VerkkuUkkeli/Kiihdytin/(threads)

Thread 3 (2019-11-04):

Acrylic core with a detachable section for module interchange

chiplet, 2019-11-04:
* [x] Find where to buy appropriate acrylic tubing
* [ ] How to bend the tube to a perfect circle?
* [ ] Make jig for bending the tube

chiplet, 2024-07-03:
Acrylic was difficult to bend consistently so going for bare 3D printed accelerator tube.

Closed 2024-07-03.

Thread 4 (2019-11-04):

Self-contained accelerator modules with integrated sensors, communication bus, actuators, and debug interface

VerkkuUkkeli, 2019-11-04:
TODO: elaborate

VerkkuUkkeli, 2019-12-21:
Duplicate of #6

VerkkuUkkeli, 2019-12-21:
Reconsidering this, #6 is more about the electronics design for the segment control unit. This issue is about the status of the whole segment, including electrical and mechanical design.

VerkkuUkkeli, 2020-01-26:
SCUs will be no longer used so the issue is obsolete.

Closed 2020-01-26.

Thread 5 (2019-11-04):

Design motherboard v1

chiplet, 2019-11-04:
General:
* [x] choose microcontroller [STM32F303RE](https://www.digikey.fi/products/fi/integrated-circuits-ics/embedded-microcontrollers/685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)
* [x] board schematics
* [x] board layout

Power Supply:
* It's probably best to use a separate power supply for powering the electromagnet coils and the control circuitry to avoid EMC issues
* [x] regulate required voltages from an external wall wart
  * [x] 3.3V for the microcontroller digital logic
  * [x] 3.3V microcontroller analog reference

Interfaces:
* [x] JTAG
* [x] ST-LINK/V2-1 debugger
* [x] stack connector(s) to electromagnet driver board

TODO:
* [x] Logic level conversion from mcu to RGB

Ottis1, 2019-12-21:
This is not needed anymore since motherboard functionality is assigned to one of the segments?

VerkkuUkkeli, 2020-01-26:
MCU selection:
* All analog circuitry (photo gate sensors) shall convert their measures to digital format so the microcontroller does not have to deal with analog signals.

MCU requirements
* [ ] Enough GPIO pins (at least to support for adding IO expansion for all required signals)
  * segment indicator LEDs (16)
  * motherboard RGB (1)
  * driver board RGB (1) (can be chained with motherboard RGB)
  * electromagnet control signals (16)
  * debug UART (2)
* [ ] UART
* [ ] QFP package

VerkkuUkkeli, 2020-01-26:
## GPIO expansion considerations
Segment indicator LEDs can be driven with the control signals without much issue. A good solution would be to use a LED driver IC with 16 outputs and serial control interface, or maybe even a shift register.

IO expansion ICs allow for bidirectional I/O. This is not necessary for the segment indicators, but would be useful for reading sensors.

Shift registers:
[SN74HC595](https://www.digikey.fi/product-detail/fi/texas-instruments/SN74HC595PWR/296-23258-1-ND/1830780) is currently used for prototyping. These can be chained so 16 indicator LEDs can be controlled over a serial connection with 3 lines in total.

VerkkuUkkeli, 2020-08-16:
## MCU Implementation

TODO:
[ ] Copy reference design from STM32F3 hardware development [app note](https://www.st.com/resource/en/application_note/dm00070391-getting-started-with-stm32f3-series-hardware-development-stmicroelectronics.pdf)

chiplet, 2020-10-31:
First revision design is complete!

Closed 2020-10-31.

Thread 6 (2019-11-04):

Design Segment Control Unit (SCU) v1 electronics

VerkkuUkkeli, 2019-11-04:
General:
* [x] choose microcontroller
* [ ] sensor circuit
* [ ] electromagnet driver circuit
* [ ] board schematics
* [ ] board layout

Interfaces:
* [x] design debugger interface -- using SWD from STM32F0DISCOVERY board (ST-LINK/V2)
* [x] choose communication bus

VerkkuUkkeli, 2019-11-04:
MCU functions:
* photogate sensor(s)
  - read sensor value (analogue)
  - control IR diode
* drive high(ish) voltage electromagnet
  - control relay/FET
* indicator led(s) for magnet position
* debug
  - UART

MCU requirements
* [ ] ADC
* [ ] GPIO (at least 3)
* [ ] UART
* [ ] Small footprint
* [ ] QFP package
* [ ] Low cost

VerkkuUkkeli, 2019-12-18:
[STM32F072C8T6TR](https://www.digikey.fi/product-detail/en/stmicroelectronics/STM32F072C8T6TR/497-17359-1-ND/8024128) looks like a suitable MCU.

[datasheet](https://www.st.com/content/ccc/resource/technical/document/datasheet/cd/46/43/83/22/d3/40/c8/DM00090510.pdf/files/DM00090510.pdf/jcr:content/translations/en.DM000905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)

VerkkuUkkeli, 2019-12-18:
Also remember to by a [STM32F0 discovery](https://www.digikey.fi/product-detail/en/stmicroelectronics/STM32F0DISCOVERY/497-12876-ND/3045359) board for flashing.

VerkkuUkkeli, 2019-12-18:
TODO:
* [ ] Choose regulator(s) for MCU
* [ ] Choose flashing interface connector
* [ ] Choose FETs / relays used
* [ ] Choose CAN transceiver

VerkkuUkkeli, 2019-12-21:
HSE crystal selection:

[ECS-80-18-30B-JEM-TR](https://www.digikey.fi/product-detail/fi/ecs-inc/ECS-80-18-30B-JEM-TR/XC2105CT-ND/5875589) seems suitable.

gain margin = 18.7 (> 5 so all good)

computed with values:
* ESR = 100 ohm
* C_L = 18pF
* C_0 = 5pF
* F = 8 MHz
* g_m = 10 mA/V

See [AN2867](https://www.st.com/content/ccc/resource/technical/document/application_note/c6/eb/5e/11/e3/69/43/eb/CD00221665.pdf/files/CD00221665.pdf/jcr:content/translations/en.C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) section 3.4 for formulae

VerkkuUkkeli, 2019-12-22:
There probably isn't going to be enough space for a relay... :(

Relays would be nice because they make nice clicking sounds, but they are slow and big compared to load switches. Load switches also seem to be preferable over using plain FETs as they have adequate current and voltage range (4A at 12V) with much smaller footprint and additional protection circuitry.

[BTS50451EJAXUMA1](https://www.digikey.fi/product-detail/fi/infineon-technologies/BTS50451EJAXUMA1/BTS50451EJAXUMA1CT-ND/5413734) seems promising for the electromagnet driver. The max load inductance must still be verified to see if this IC can be used for driving the electromagnet.

VerkkuUkkeli, 2020-01-26:
SCUs will be no longer used so the issue is obsolete.

Closed 2020-01-26.

Thread 7 (2019-12-21):

Configure SCU CAN peripheral

VerkkuUkkeli, 2019-12-21:
Configure STM32F072 bxCAN peripheral for use.

TODO:
* [ ] Enable peripheral clock (CANEN bit in RCC_APB1ENR register)
* [ ] Configure APB clock (PCLK)
* [ ] Bit timing -- prescaler for bxCAN
* [ ] Bit timing -- nominal bit timing and sample point ([see spec](http://esd.cs.ucr.edu/webres/can20.pdf))

VerkkuUkkeli, 2019-12-21:
The bxCAN peripheral uses APB bus clock (PCLK).

VerkkuUkkeli, 2020-01-26:
SCUs will be no longer used so the issue is obsolete.

Closed 2020-01-26.

Thread 9 (2019-12-21):

Segment CAD design

chiplet, 2019-12-21:
CAD design for accelerator segments

TODO and things to consider:
* [x] accommodate segment PCBs
* [x] accommodate photo gate sensor
* [x] accommodate electromagnet
* [ ] ~~places for electrical connectors for inter-module connections (chain units together)~~
* [ ] cable management
* [ ] EMC issues and wiring placement (try to minimise interference by smart cable routing)
* [x] how to manufacture, design with manufacturing in mind (3D printing?)

TODO: add more considerations as they come up

VerkkuUkkeli, 2020-02-20:
## Sensor placement considerations:
* [ ] Should the pipe have a hole for mounting the sensors
  * [ ] Test if the sensor works through the pipe without mounting holes

VerkkuUkkeli, 2020-03-21:
Relays / FETs are placed on top of the motherboard so there will be no need to try to accommodate them in the segments.

Ottis1, 2021-01-19:
It seems to me that only the cable management and wiring placement considerations are left in this issue. Controlling the segments happens on the motherboard so there will be no segment PCBs. Also, in my understanding the units will not be chained together in any way.
3D printing was chosen as the manufacturing method.

chiplet, 2024-07-06:
Segments have been designed and printed already

Closed 2024-07-06.

Thread 11 (2020-02-07):

Motherboard clock configuration

chiplet, 2020-02-07:
Configure the MCU to use the HSE as the clock source.

The following part of the [hardware design guide](https://www.st.com/content/ccc/resource/technical/document/application_note/31/14/f4/9d/d3/8f/48/2b/DM00070391.pdf/files/DM00070391.pdf/jcr:content/translations/en.D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) seems useful for software configuration:
"The HSERDY flag in the Clock control register (RCC_CR) indicates if the HSE oscillator is
stable or not. At startup, the clock is not released until this bit is set by hardware. An
interrupt can be generated if enabled in the Clock interrupt register (RCC_CIR).
The HSE Crystal can be switched on and off using the HSEON bit in the Clock control
register (RCC_CR)."

chiplet, 2024-07-06:
Done. The stm32f3xx-hal crate offers a convenient interface for configuring core and peripheral clocks:
https://docs.rs/stm32f3xx-hal/0.10.0/stm32f3xx_hal/rcc/index.html

Closed 2024-07-06.

Thread 13 (2020-09-03):

Design relelauta v.2.0

chiplet, 2020-09-03:
# Abbreviations
* EM - electromagnet

# TODO:
* [x] Measure EM inductance
* [x] Choose EM driver
  * Relay?
  * Load switch?
  * MOSFET?
* [ ] Indicator LEDs for EM drivers
  * [ ] Amplifiers for indicator led signal so that EM control signals are not loaded by the LEDs

## Electromagnet Specifications
* Resistance ~2 Ohm
* Inductance ~ 430 µH
=> Assuming 10A current, energy stored in inductor is E = 22mJ

## Electromagnet driver selection considerations
* High enough load current (around 10A, TBD)
* High enough power package to withstand generated heat
* Be able to withstand inductive "kicks" when switching off the electromagnet
  * Are external flywheel diodes required?
* Nice enough package for easy soldering

chiplet, 2021-01-18:
STM32 GPIO pins are a bit problematic, at least on the Blue Pill dev board. According to the reference manual, the GPIO pins should reset to floating input configuration. The configuration register contents match this configuration when inspecting memory. However, for whatever reason, when measured, the pin is pulled up to 3.3V. The boards were ordered from ebay so the issue might be that the MCU on the devboard is actually a clone which doesn't implement the floating state correctly.

Whatever the reason, this is problematic since when the pin is pulled to 3.3V an electromagnet controlled by the pin would turn on. This is not an issue after the pin has been configured as an output. However, when debugging with a breakpoint set to main, this would turn on **all** electromagnets by default at the same time and the electronics are not designed to handle that.

As a workaround I'm connecting an external 1k pull-down resistor which seems to pull the pin to around 0.7V when left "floating".

Closed 2021-05-16.

Thread 15 (2021-05-16):

Motherboard firmware

Ottis1, 2021-05-16:
Develop the firmware for the motherboard which controls the electromagnets, reads the sensors and communicates with the PC command interface via a serial connection.

TODO:

- [ ] serial communication
- [ ]

chiplet, 2024-07-06:
**TODO:**
- [ ] Serial communication
  - [ ] USART1 driver
  - [ ] Packet-based request-acknowledge command link
- [x] RGB animation (make it look like cool alien brains!)
- [ ] Sensor input interrupts
- [ ] Acceleration control sequencing

Thread 18 (2024-07-06):

Motherboard v1.3

chiplet, 2024-07-06:
Create a new motherboard hardware revision fixing the pin assignment issues in motherboard v1.2. At least RGB data signal has been moved to PA7 corresponding to SPI1_MOSI with AF5.
