VerkkuUkkeli/Kiihdytin/hw/relelauta/v2/relelauta/relelauta.kicad_pcb

## KiCad design hw/relelauta/v2/relelauta/relelauta.kicad_pcb (2021-01-31)

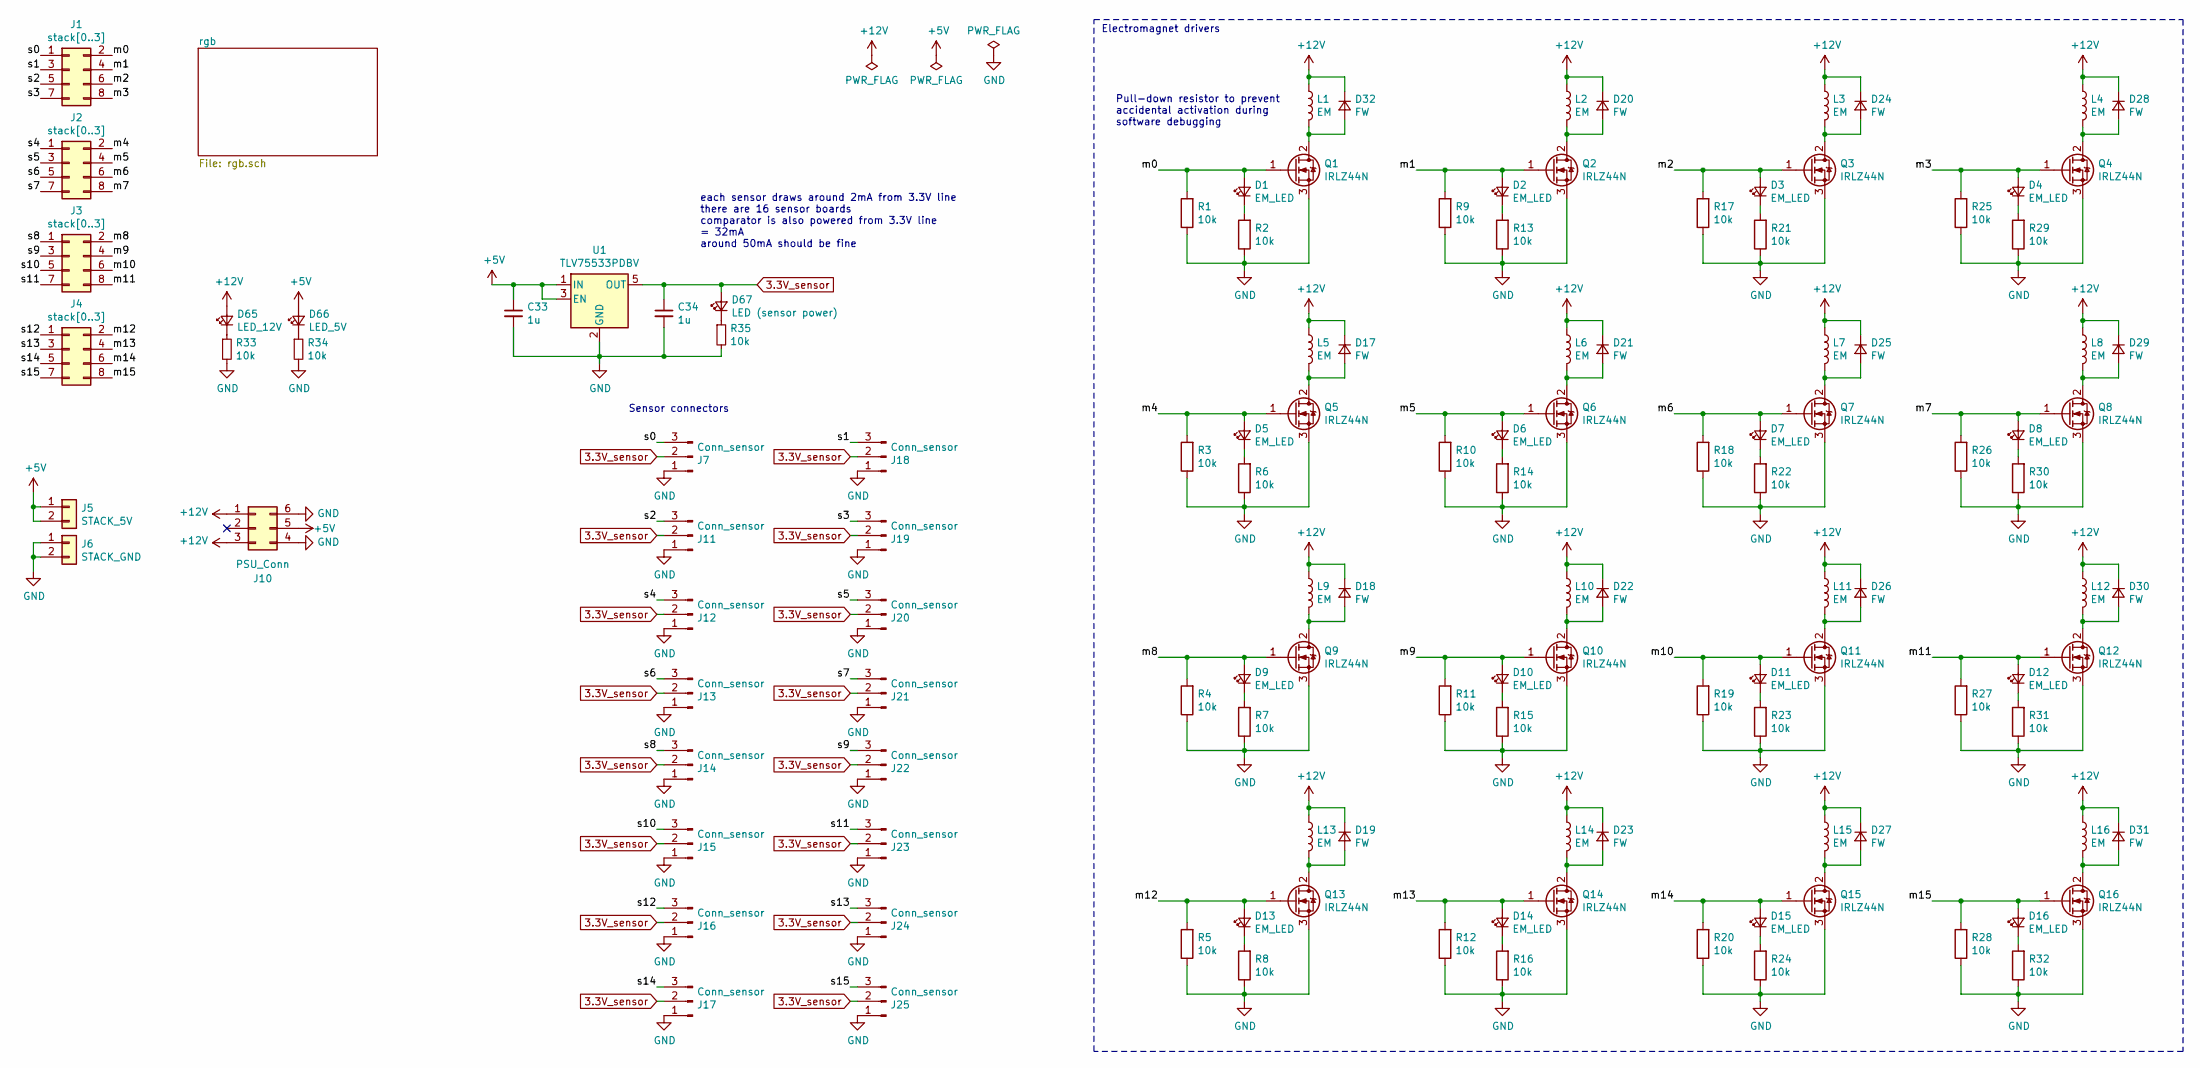
[picture p1: schematic relelauta.sch]

Parts:
C33, C34: 1u; C_0603_1608Metric
D1, D2, D3, D4, D5, D6, D7, D8, D9, D10, D11, D12, D13, D14, D15, D16: EM_LED; LED_0805_2012Metric
D17, D18, D19, D20, D21, D22, D23, D24, D25, D26, D27, D28, D29, D30, D31, D32: FW; D_DO-41_SOD81_P7.62mm_Horizontal
D65: LED_12V; LED_0805_2012Metric
D66: LED_5V; LED_0805_2012Metric
D67: LED (sensor power); LED_0805_2012Metric
J1, J2, J3, J4: stack[0..3]; PinSocket_2x04_P2.54mm_Vertical
J5: STACK_5V; PinSocket_1x02_P2.54mm_Vertical
J6: STACK_GND; PinSocket_1x02_P2.54mm_Vertical
J7, J11, J12, J13, J14, J15, J16, J17, J18, J19, J20, J21, J22, J23, J24, J25: Conn_sensor; PinHeader_1x03_P2.54mm_Horizontal
J10: PSU_Conn; Molex_Mini-Fit_Jr_5566-06A_2x03_P4.20mm_Vertical
L1, L2, L3, L4, L5, L6, L7, L8, L9, L10, L11, L12, L13, L14, L15, L16: EM; TerminalBlock_bornier-2_P5.08mm
Q1, Q2, Q3, Q4, Q5, Q6, Q7, Q8, Q9, Q10, Q11, Q12, Q13, Q14, Q15, Q16: IRLZ44N; TO-220-3_Vertical
R1, R2, R3, R4, R5, R6, R7, R8, R9, R10, R11, R12, R13, R14, R15, R16, R17, R18, R19, R20, R21, R22, R23, R24, R25, R26, R27, R28, R29, R30, R31, R32: 10k; R_0603_1608Metric
R33, R34, R35: 10k; R_0805_2012Metric
U1: TLV75533PDBV; SOT-23-5

Connections:
3.3V_sensor: C34.1, D67.2 (A), J7.2, J11.2, J12.2, J13.2, J14.2, J15.2, J16.2, J17.2, J18.2, J19.2, J20.2, J21.2, J22.2, J23.2, J24.2, J25.2, U1.5 (OUT)
+5V: C33.1, D66.2 (A), J5.1, J5.2, J10.5, U1.1 (IN), U1.3 (EN)
+12V: D17.1 (K), D18.1 (K), D19.1 (K), D20.1 (K), D21.1 (K), D22.1 (K), D23.1 (K), D24.1 (K), D25.1 (K), D26.1 (K), D27.1 (K), D28.1 (K), D29.1 (K), D30.1 (K), D31.1 (K), D32.1 (K), D65.2 (A), J10.1, J10.3, L1.1, L2.1, L3.1, L4.1, L5.1, L6.1, L7.1, L8.1, L9.1, L10.1, L11.1, L12.1, L13.1, L14.1, L15.1, L16.1
/m0: D1.2 (A), J1.2, Q1.1 (G), R1.2
/m1: D2.2 (A), J1.4, Q2.1 (G), R9.2
/m2: D3.2 (A), J1.6, Q3.1 (G), R17.2
/m3: D4.2 (A), J1.8, Q4.1 (G), R25.2
/m4: D5.2 (A), J2.2, Q5.1 (G), R3.2
/m5: D6.2 (A), J2.4, Q6.1 (G), R10.2
/m6: D7.2 (A), J2.6, Q7.1 (G), R18.2
/m7: D8.2 (A), J2.8, Q8.1 (G), R26.2
/m8: D9.2 (A), J3.2, Q9.1 (G), R4.2
/m9: D10.2 (A), J3.4, Q10.1 (G), R11.2
/m10: D11.2 (A), J3.6, Q11.1 (G), R19.2
/m11: D12.2 (A), J3.8, Q12.1 (G), R27.2
/m12: D13.2 (A), J4.2, Q13.1 (G), R5.2
/m13: D14.2 (A), J4.4, Q14.1 (G), R12.2
/m14: D15.2 (A), J4.6, Q15.1 (G), R20.2
/m15: D16.2 (A), J4.8, Q16.1 (G), R28.2
/s0: J1.1, J7.3
/s1: J1.3, J18.3
/s2: J1.5, J11.3
/s3: J1.7, J19.3
/s4: J2.1, J12.3
/s5: J2.3, J20.3
/s6: J2.5, J13.3
/s7: J2.7, J21.3
/s8: J3.1, J14.3
/s9: J3.3, J22.3
/s10: J3.5, J15.3
/s11: J3.7, J23.3
/s12: J4.1, J16.3
/s13: J4.3, J24.3
/s14: J4.5, J17.3
/s15: J4.7, J25.3
GND: C33.2, C34.2, J6.1, J6.2, J7.1, J10.4, J10.6, J11.1, J12.1, J13.1, J14.1, J15.1, J16.1, J17.1, J18.1, J19.1, J20.1, J21.1, J22.1, J23.1, J24.1, J25.1, Q1.3 (S), Q2.3 (S), Q3.3 (S), Q4.3 (S), Q5.3 (S), Q6.3 (S), Q7.3 (S), Q8.3 (S), Q9.3 (S), Q10.3 (S), Q11.3 (S), Q12.3 (S), Q13.3 (S), Q14.3 (S), Q15.3 (S), Q16.3 (S), R1.1, R2.1, R3.1, R4.1, R5.1, R6.1, R7.1, R8.1, R9.1, R10.1, R11.1, R12.1, R13.1, R14.1, R15.1, R16.1, R17.1, R18.1, R19.1, R20.1, R21.1, R22.1, R23.1, R24.1, R25.1, R26.1, R27.1, R28.1, R29.1, R30.1, R31.1, R32.1, R33.2, R34.2, R35.2, U1.2 (GND); also elsewhere on the board
unnamed: D1.1 (K), R2.2
unnamed: D2.1 (K), R13.2
unnamed: D3.1 (K), R21.2
unnamed: D4.1 (K), R29.2
unnamed: D5.1 (K), R6.2
unnamed: D6.1 (K), R14.2
unnamed: D7.1 (K), R22.2
unnamed: D8.1 (K), R30.2
unnamed: D9.1 (K), R7.2
unnamed: D10.1 (K), R15.2
unnamed: D11.1 (K), R23.2
unnamed: D12.1 (K), R31.2
unnamed: D13.1 (K), R8.2
unnamed: D14.1 (K), R16.2
unnamed: D15.1 (K), R24.2
unnamed: D16.1 (K), R32.2
unnamed: D17.2 (A), L5.2, Q5.2 (D)
unnamed: D18.2 (A), L9.2, Q9.2 (D)
unnamed: D19.2 (A), L13.2, Q13.2 (D)
unnamed: D20.2 (A), L2.2, Q2.2 (D)
unnamed: D21.2 (A), L6.2, Q6.2 (D)
unnamed: D22.2 (A), L10.2, Q10.2 (D)
unnamed: D23.2 (A), L14.2, Q14.2 (D)
unnamed: D24.2 (A), L3.2, Q3.2 (D)
unnamed: D25.2 (A), L7.2, Q7.2 (D)
unnamed: D26.2 (A), L11.2, Q11.2 (D)
unnamed: D27.2 (A), L15.2, Q15.2 (D)
unnamed: D28.2 (A), L4.2, Q4.2 (D)
unnamed: D29.2 (A), L8.2, Q8.2 (D)
unnamed: D30.2 (A), L12.2, Q12.2 (D)
unnamed: D31.2 (A), L16.2, Q16.2 (D)
unnamed: D32.2 (A), L1.2, Q1.2 (D)
unnamed: D65.1 (K), R33.1
unnamed: D66.1 (K), R34.1
unnamed: D67.1 (K), R35.1

Notes on the sheet:
Pull-down resistor to prevent accidental activation during software debugging
Sensor connectors
each sensor draws around 2mA from 3.3V line there are 16 sensor boards comparator is also powered from 3.3V line = 32mA around 50mA should be fine
Electromagnet drivers

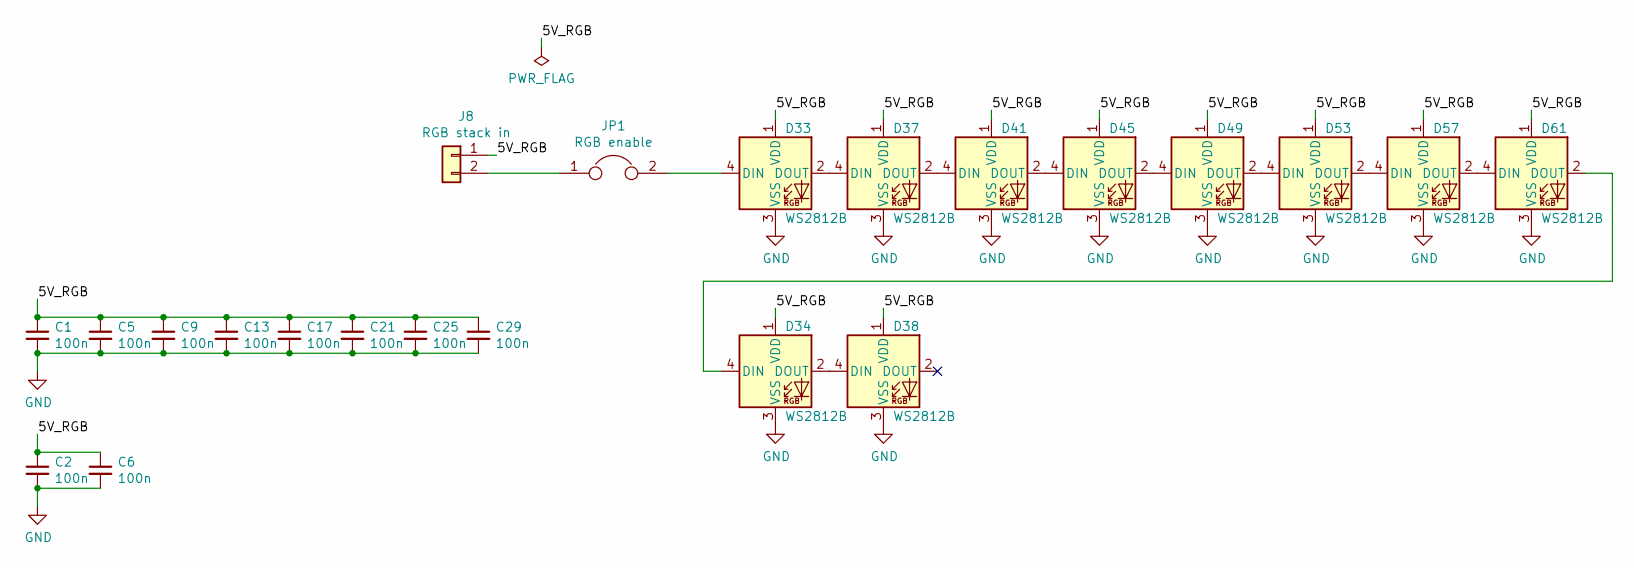
[picture p2: schematic rgb.sch]

Parts:
C1, C2, C5, C6, C9, C13, C17, C21, C25, C29: 100n; C_0603_1608Metric
D33, D34, D37, D38, D41, D45, D49, D53, D57, D61: WS2812B; LED_WS2812B_PLCC4_5.0x5.0mm_P3.2mm
J8: RGB stack in; PinSocket_1x02_P2.54mm_Vertical
JP1: RGB enable; PinHeader_2x01_P2.54mm_Vertical

Connections:
/rgb/5V_RGB: C1.1, C2.1, C5.1, C6.1, C9.1, C13.1, C17.1, C21.1, C25.1, C29.1, D33.1 (VDD), D34.1 (VDD), D37.1 (VDD), D38.1 (VDD), D41.1 (VDD), D45.1 (VDD), D49.1 (VDD), D53.1 (VDD), D57.1 (VDD), D61.1 (VDD), J8.1
GND: C1.2, C2.2, C5.2, C6.2, C9.2, C13.2, C17.2, C21.2, C25.2, C29.2, D33.3 (VSS), D34.3 (VSS), D37.3 (VSS), D38.3 (VSS), D41.3 (VSS), D45.3 (VSS), D49.3 (VSS), D53.3 (VSS), D57.3 (VSS), D61.3 (VSS); also elsewhere on the board
unnamed: D33.2 (DOUT), D37.4 (DIN)
unnamed: D33.4 (DIN), JP1.2
unnamed: D34.2 (DOUT), D38.4 (DIN)
unnamed: D34.4 (DIN), D61.2 (DOUT)
unnamed: D37.2 (DOUT), D41.4 (DIN)
unnamed: D41.2 (DOUT), D45.4 (DIN)
unnamed: D45.2 (DOUT), D49.4 (DIN)
unnamed: D49.2 (DOUT), D53.4 (DIN)
unnamed: D53.2 (DOUT), D57.4 (DIN)
unnamed: D57.2 (DOUT), D61.4 (DIN)
unnamed: J8.2, JP1.1

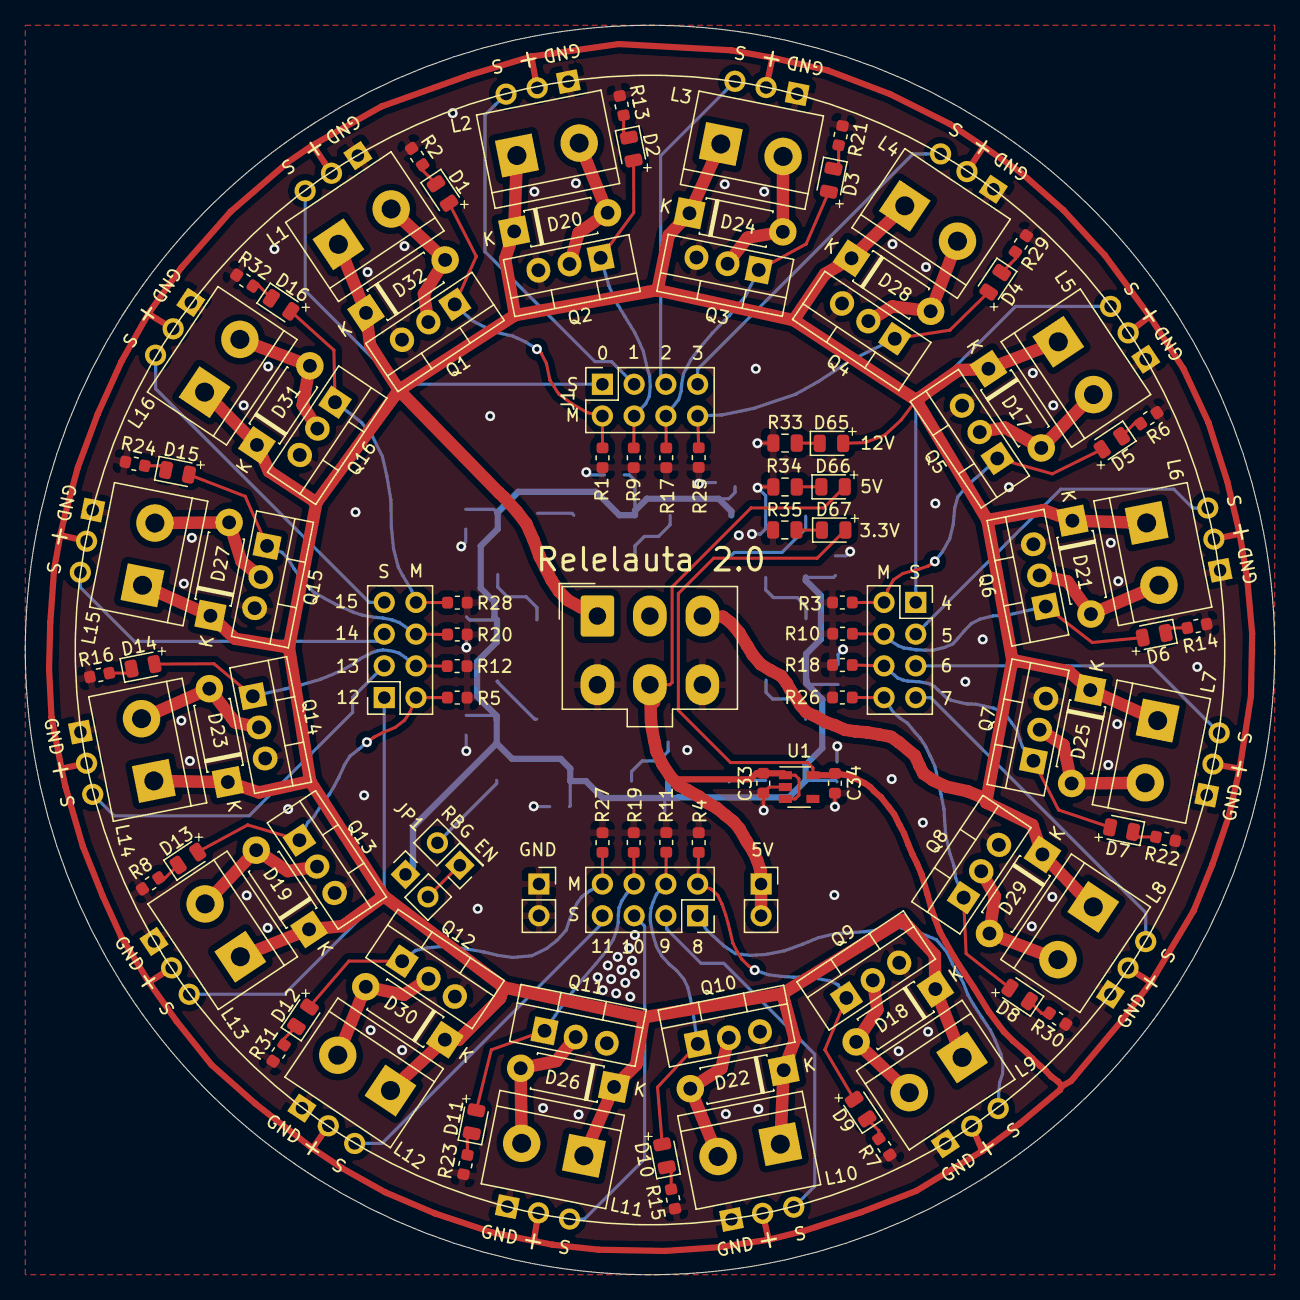
[picture p3: board relelauta.kicad_pcb from above]

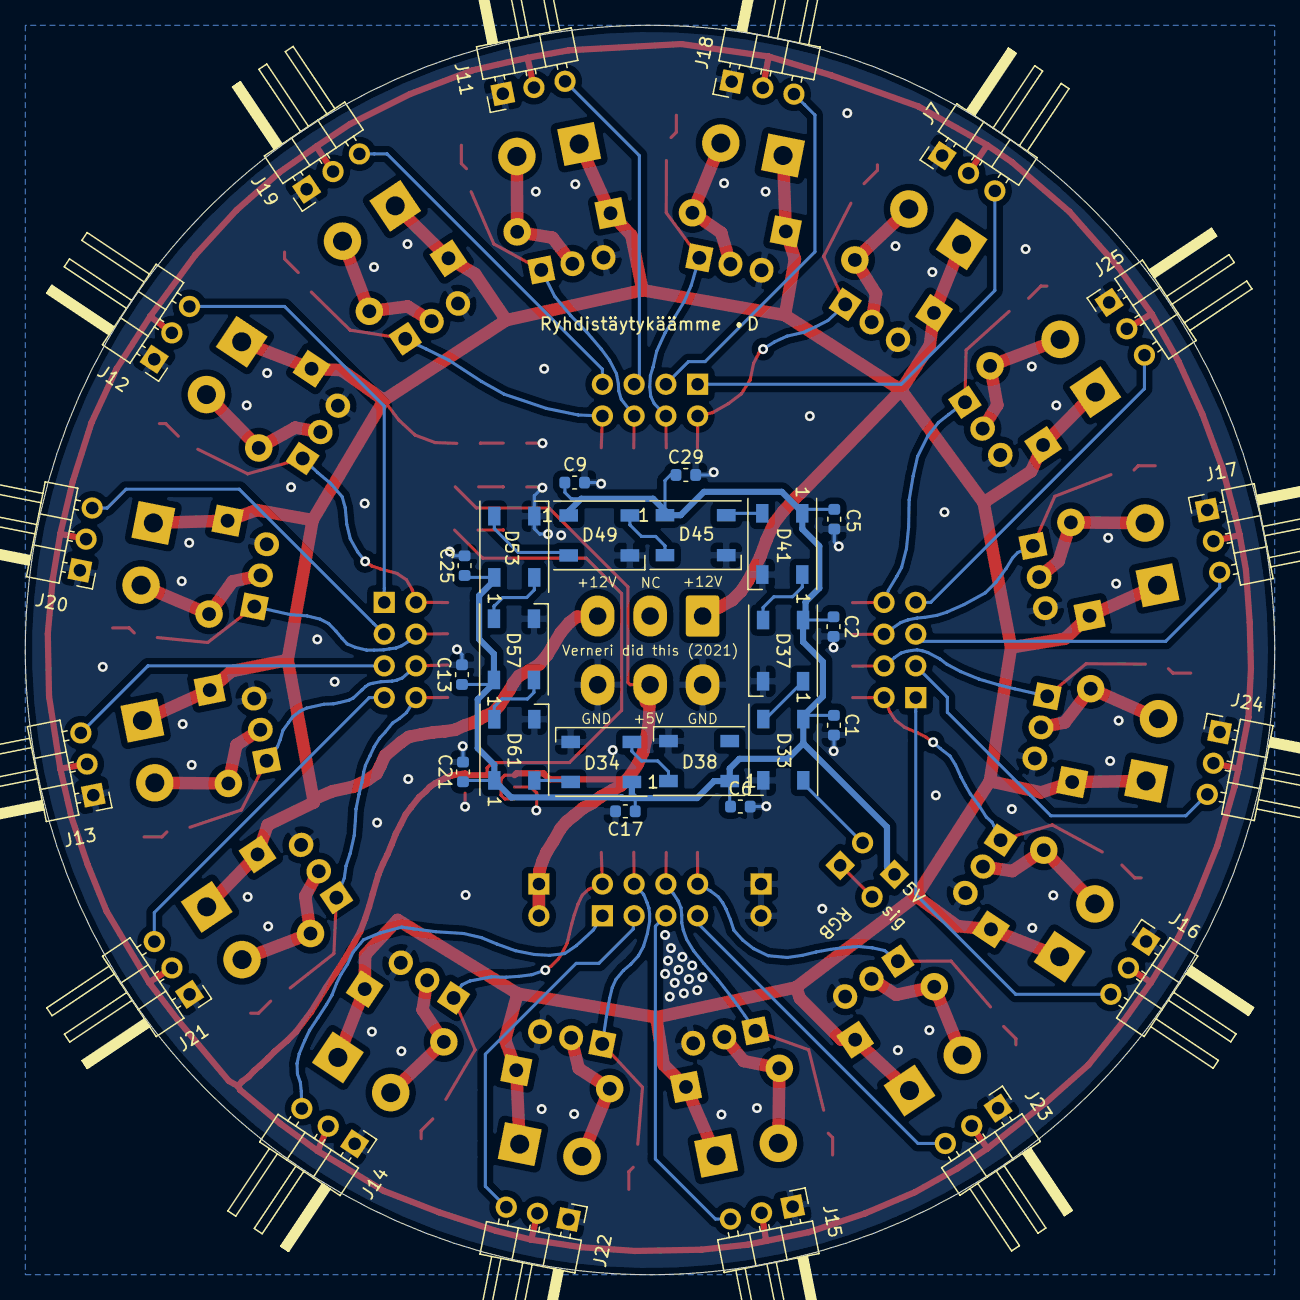
[picture p4: board relelauta.kicad_pcb from below]

Board: 2 copper layers, 100.0 x 100.0 mm, 150 parts (36 on the bottom side), 83 nets.
