VerkkuUkkeli/Kiihdytin/hw/sensorilauta/sensorilauta.kicad_pcb

## KiCad design hw/sensorilauta/sensorilauta.kicad_pcb (2021-01-31)

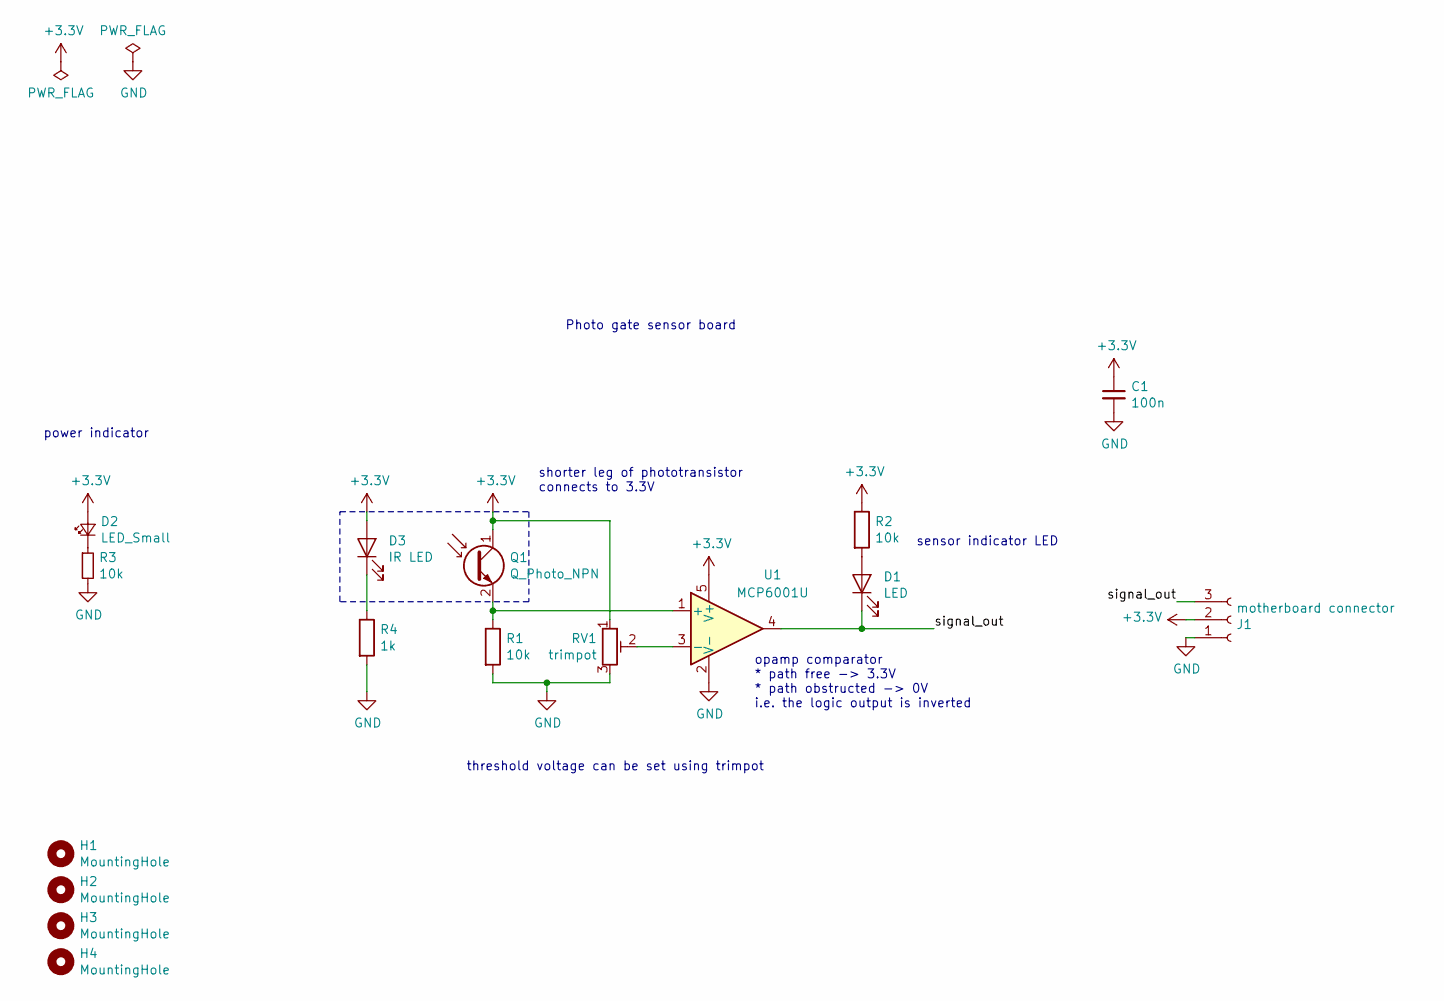
[picture p5: schematic sensorilauta.sch]

Parts:
C1: 100n; C_0805_2012Metric_Pad1.15x1.40mm_HandSolder
D1: LED; LED_D5.0mm
D2: LED_Small; LED_0805_2012Metric_Castellated
D3: IR LED; PinHeader_2x01_P2.54mm_Vertical
H1, H2, H3, H4: MountingHole; MountingHole_4.3mm_M4
J1: motherboard connector; PinHeader_1x03_P2.54mm_Horizontal
Q1: Q_Photo_NPN; PinHeader_2x01_P2.54mm_Vertical
R1, R2, R3: 10k; R_0805_2012Metric_Pad1.15x1.40mm_HandSolder
R4: 1k; R_0805_2012Metric_Pad1.15x1.40mm_HandSolder
RV1: trimpot; Potentiometer_Vishay_TS53YJ_Vertical
U1: MCP6001U; SOT-23-5_HandSoldering

Connections:
+3V3: C1.1, D2.2 (A), D3.2 (A), J1.2, Q1.1 (C), R2.1, RV1.1, U1.5 (V+)
/signal_out: D1.1 (K), J1.3, U1.4
GND: C1.2, J1.1, R1.2, R3.2, R4.2, RV1.3, U1.2 (V-)
unnamed: D1.2 (A), R2.2
unnamed: D2.1 (K), R3.1
unnamed: D3.1 (K), R4.1
unnamed: Q1.2 (E), R1.1, U1.1 (+)
unnamed: RV1.2, U1.3 (-)

Notes on the sheet:
Photo gate sensor board
opamp comparator * path free -> 3.3V * path obstructed -> 0V i.e. the logic output is inverted
threshold voltage can be set using trimpot
sensor indicator LED
power indicator
shorter leg of phototransistor connects to 3.3V

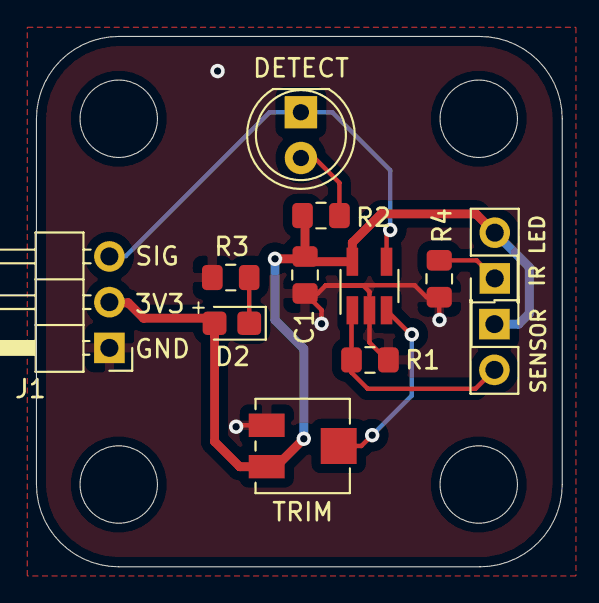
[picture p6: board sensorilauta.kicad_pcb from above]

Board: 2 copper layers, 29.2 x 29.5 mm, 16 parts (0 on the bottom side), 8 nets.
