VerkkuUkkeli/Kiihdytin/hw/motherboard/main/main.kicad_pcb

## KiCad design hw/motherboard/main/main.kicad_pcb (2021-01-31)

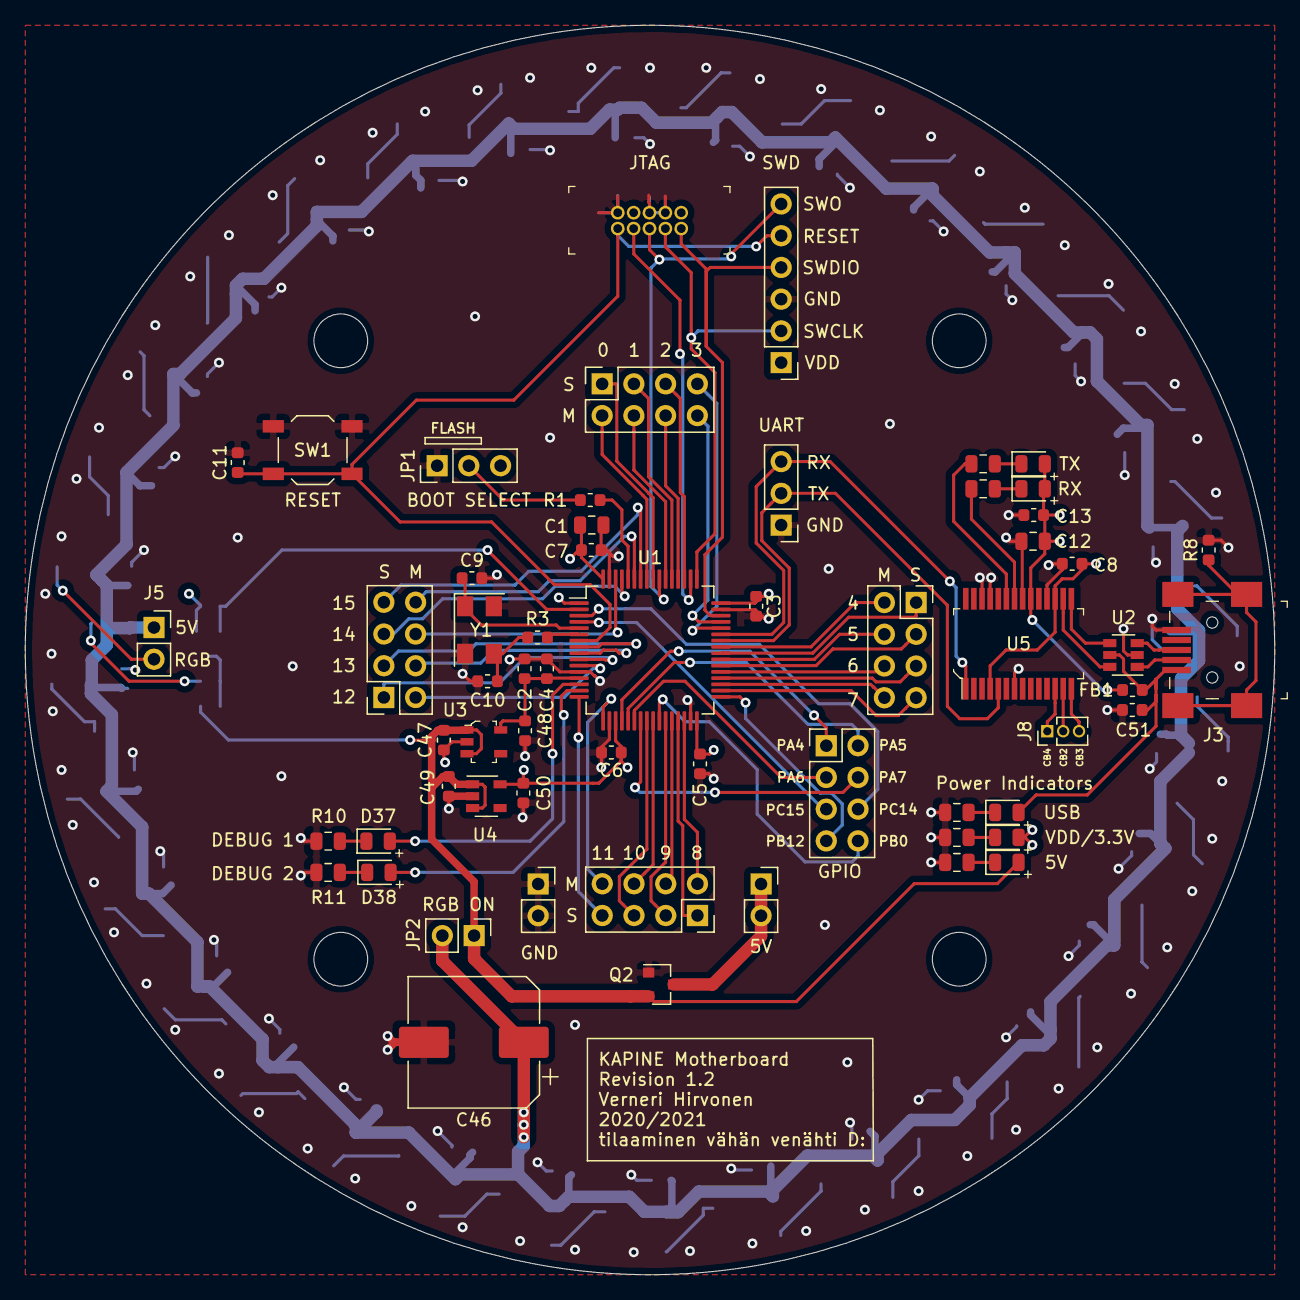
[picture p7: board hw/motherboard/main/main.kicad_pcb from above]

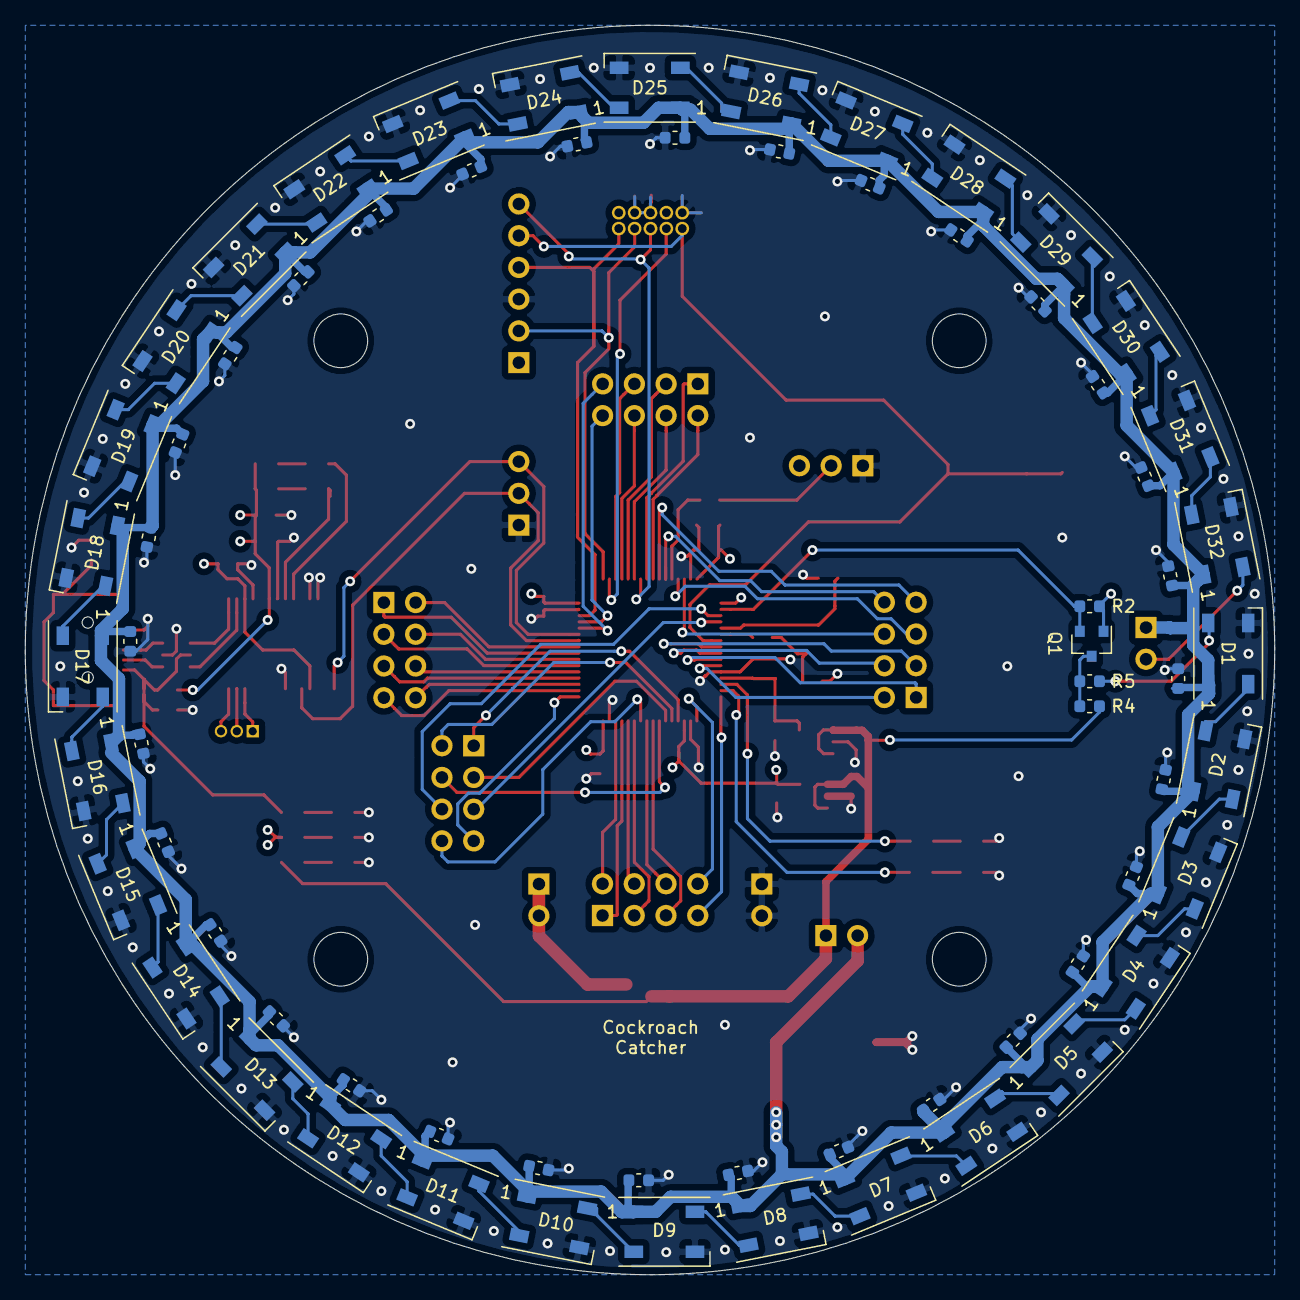
[picture p8: board hw/motherboard/main/main.kicad_pcb from below]

Board: 4 copper layers, 100.0 x 100.0 mm, 132 parts (68 on the bottom side), 115 nets.

Parts:
C1, C12: 4.7u; C_0805_2012Metric
C2, C47, C48, C49, C50: 1u; C_0603_1608Metric
C3, C5, C6, C7, C8, C11, C13, C14, C15, C16, C17, C18, C19, C20, C21, C22, C23, C24, C25, C26, C27, C28, C29, C30, C31, C32, C33, C34, C35, C36, C37, C38, C39, C40, C41, C42, C43, C44, C45: 100n; C_0603_1608Metric
C4, C51: 10n; C_0603_1608Metric
C9, C10: 27p; C_0603_1608Metric
C46: 1000u; CP_Elec_10x10
D1, D2, D3, D4, D5, D6, D7, D8, D9, D10, D11, D12, D13, D14, D15, D16, D17, D18, D19, D20, D21, D22, D23, D24, D25, D26, D27, D28, D29, D30, D31, D32: WS2812B; LED_WS2812B_PLCC4_5.0x5.0mm_P3.2mm
D33: LED_5V; LED_0805_2012Metric
D34: LED_3V3; LED_0805_2012Metric
D35: LED_TX; LED_0805_2012Metric
D36: LED_RX; LED_0805_2012Metric
D37: DEBUG_1; LED_0805_2012Metric
D38: DEBUG_2; LED_0805_2012Metric
D39: LED_USB; LED_0805_2012Metric
FB1: Ferrite_Bead; L_0603_1608Metric
H1, H2, H3, H4: MountingHole; MountingHole_4.3mm_M4
J1: SWD holes; PinHeader_1x06_P2.54mm_Vertical
J2: Conn_ARM_JTAG_SWD_10; PinHeader_2x5_P1.27mm_Drill.7mm
J3: 690-005-299-043; USB_Mini_B_Female_690-005-299-043
J4: STACK_GND; PinSocket_1x02_P2.54mm_Vertical
J5: RGB stack; PinSocket_1x02_P2.54mm_Vertical
J6: STACK_5V; PinSocket_1x02_P2.54mm_Vertical
J7: UART pins; PinHeader_1x03_P2.54mm_Vertical
J8: CBUS[2..4]; PinHeader_1x03_P1.27mm_Vertical
J9, J10, J11, J12: stack[0..3]; PinSocket_2x04_P2.54mm_Vertical
J13: GPIO; PinHeader_2x04_P2.54mm_Vertical
JP1: boot select; PinHeader_1x03_P2.54mm_Vertical
JP2: RGB ENABLE; PinHeader_1x02_P2.54mm_Vertical
Q1: BSS138; SOT-23
Q2: Q_PMOS_GSD; SOT-23
R1, R2, R4: 10k; R_0603_1608Metric
R3: 390; R_0603_1608Metric
R5: 470; R_0603_1608Metric
R6, R7, R9, R10, R11, R12, R13: 1k; R_0805_2012Metric
R8: 0; R_0603_1608Metric
SW1: SW_Push; SW_SPST_TL3342
U1: STM32F303RETx; LQFP-64_10x10mm_P0.5mm
U2: USBLC6-2SC6; SOT-23-6
U3: LP5907MFX-3_3_NOPB; SOT-753
U4: TLV75533PDBV; SOT-23-5
U5: FT232RL-REEL; SSOP-28_W5.30mm
Y1: HSE; Crystal_SMD_Abracon_ABM3C-4Pin_5.0x3.2mm

Connections:
+5V: C47.1, C49.1, D33.2, JP2.1, Q2.2, R4.1, U3.1, U3.3, U4.1, U4.3
/DEBUG_1: D37.2, U1.14
/DEBUG_2: D38.2, U1.15
/JTAG_TCK: J1.2, J2.4, U1.49
/JTAG_TDI: J2.8, U1.50
/JTAG_TDO: J1.6, J2.6, U1.55
/JTAG_TMS: J1.4, J2.2, U1.46
/PA4: J13.1, U1.20
/PA5: J13.2, U1.21
/PA6: J13.3, U1.22
/PA7: J13.4, U1.23
/PB0: J13.8, U1.26
/PB12: J13.7, U1.33
/PC14: J13.6, U1.3
/PC15: J13.5, U1.4
/RESET#: C11.1, J1.5, J2.10, SW1.2, U1.7
/USART1_RX: J7.3, U1.43, U5.1
/USART1_TX: J7.2, U1.42, U5.5
/m0: J9.2, U1.57
/m1: J9.4, U1.54
/m2: J9.6, U1.52
/m3: J9.8, U1.45
/m4: J10.2, U1.41
/m5: J10.4, U1.39
/m6: J10.6, U1.37
/m7: J10.8, U1.35
/m8: J11.2, U1.30
/m9: J11.4, U1.28
/m10: J11.6, U1.25
/m11: J11.8, U1.17
/m12: J12.2, U1.11
/m13: J12.4, U1.9
/m14: J12.6, U1.62
/m15: J12.8, U1.59
/power/5V_in: J6.1, J6.2, Q2.3
/rgb/5V_RGB: C14.1, C15.1, C16.1, C17.1, C18.1, C19.1, C20.1, C21.1, C22.1, C23.1, C24.1, C25.1, C26.1, C27.1, C28.1, C29.1, C30.1, C31.1, C32.1, C33.1, C34.1, C35.1, C36.1, C37.1, C38.1, C39.1, C40.1, C41.1, C42.1, C43.1, C44.1, C45.1, C46.1, D1.1, D2.1, D3.1, D4.1, D5.1, D6.1, D7.1, D8.1, D9.1, D10.1, D11.1, D12.1, D13.1, D14.1, D15.1, D16.1, D17.1, D18.1, D19.1, D20.1, D21.1, D22.1, D23.1, D24.1, D25.1, D26.1, D27.1, D28.1, D29.1, D30.1, D31.1, D32.1, J5.1, JP2.2
/rgb/DIN: Q1.2, R2.2, U1.2
/s0: J9.1, U1.56
/s1: J9.3, U1.53
/s2: J9.5, U1.51
/s3: J9.7, U1.44
/s4: J10.1, U1.40
/s5: J10.3, U1.38
/s6: J10.5, U1.36
/s7: J10.7, U1.34
/s8: J11.1, U1.29
/s9: J11.3, U1.27
/s10: J11.5, U1.24
/s11: J11.7, U1.16
/s12: J12.1, U1.10
/s13: J12.3, U1.8
/s14: J12.5, U1.61
/s15: J12.7, U1.58
/uart/USB_DM: U2.6, U5.16
/uart/USB_DP: U2.4, U5.15
GND: C1.2, C2.2, C3.2, C4.2, C5.2, C6.2, C7.2, C8.2, C9.2, C10.2, C11.2, C12.2, C13.2, C14.2, C15.2, C16.2, C17.2, C18.2, C19.2, C20.2, C21.2, C22.2, C23.2, C24.2, C25.2, C26.2, C27.2, C28.2, C29.2, C30.2, C31.2, C32.2, C33.2, C34.2, C35.2, C36.2, C37.2, C38.2, C39.2, C40.2, C41.2, C42.2, C43.2, C44.2, C45.2, C46.2, C47.2, C48.2, C49.2, C50.2, C51.2, D1.3, D2.3, D3.3, D4.3, D5.3, D6.3, D7.3, D8.3, D9.3, D10.3, D11.3, D12.3, D13.3, D14.3, D15.3, D16.3, D17.3, D18.3, D19.3, D20.3, D21.3, D22.3, D23.3, D24.3, D25.3, D26.3, D27.3, D28.3, D29.3, D30.3, D31.3, D32.3, J1.3, J2.3, J2.5, J2.9, J3.5, J4.1, J4.2, J7.1, JP1.1, Q2.1, R6.2, R7.2, R8.2, R10.2, R11.2, R13.2, SW1.1, U1.12, U1.18, U1.31, U1.47, U1.63, U2.2, U3.2, U4.2, U5.7, U5.18, U5.21, U5.25, U5.26, Y1.2, Y1.4
unnamed: C8.1, U5.4, U5.17
unnamed: C9.1, U1.5, Y1.1
unnamed: C10.1, R3.2, Y1.3
unnamed: D1.2, D2.4
unnamed: D1.4, R5.1
unnamed: D2.2, D3.4
unnamed: D3.2, D4.4
unnamed: D4.2, D5.4
unnamed: D5.2, D6.4
unnamed: D6.2, D7.4
unnamed: D7.2, D8.4
unnamed: D8.2, D9.4
unnamed: D10.2, D11.4
unnamed: D9.2, D10.4
unnamed: D11.2, D12.4
unnamed: D12.2, D13.4
unnamed: D13.2, D14.4
unnamed: D14.2, D15.4
unnamed: D15.2, D16.4
unnamed: D16.2, D17.4
unnamed: D17.2, D18.4
unnamed: D18.2, D19.4
unnamed: D19.2, D20.4
unnamed: D20.2, D21.4
unnamed: D21.2, D22.4
unnamed: D22.2, D23.4
unnamed: D23.2, D24.4
unnamed: D24.2, D25.4
unnamed: D25.2, D26.4
unnamed: D26.2, D27.4
unnamed: D27.2, D28.4
unnamed: D28.2, D29.4
unnamed: D29.2, D30.4
unnamed: D30.2, D31.4
unnamed: D31.2, D32.4
unnamed: D32.2, J5.2
unnamed: D33.1, R6.1
unnamed: D34.1, R7.1
unnamed: D35.1, R9.1
unnamed: D36.1, R12.1
unnamed: D37.1, R10.1
unnamed: D38.1, R11.1
unnamed: D39.1, R13.1
unnamed: J3.2, U2.1
unnamed: J3.3, U2.3
unnamed: J3.SH, R8.1
unnamed: J8.1, U5.12
unnamed: J8.2, U5.13
unnamed: J8.3, U5.14
unnamed: JP1.2, R1.2
unnamed: Q1.3, R4.2, R5.2
unnamed: R1.1, U1.60
unnamed: R3.1, U1.6
unnamed: R9.2, U5.23
unnamed: R12.2, U5.22
VBUS: C51.1, D39.2, FB1.1, J3.1, U2.5
VCC: C12.1, C13.1, D35.2, D36.2, FB1.2, U5.20
VDD: C1.1, C3.1, C5.1, C6.1, C7.1, C50.1, D34.2, J1.1, J2.1, JP1.3, Q1.1, R2.1, U1.1, U1.19, U1.32, U1.48, U1.64, U4.5
VDDA: C2.1, C4.1, C48.1, U1.13, U3.5
