VerkkuUkkeli/Kiihdytin/hw/scu/main/main.kicad_pcb

## KiCad design hw/scu/main/main.kicad_pcb (2019-12-21)

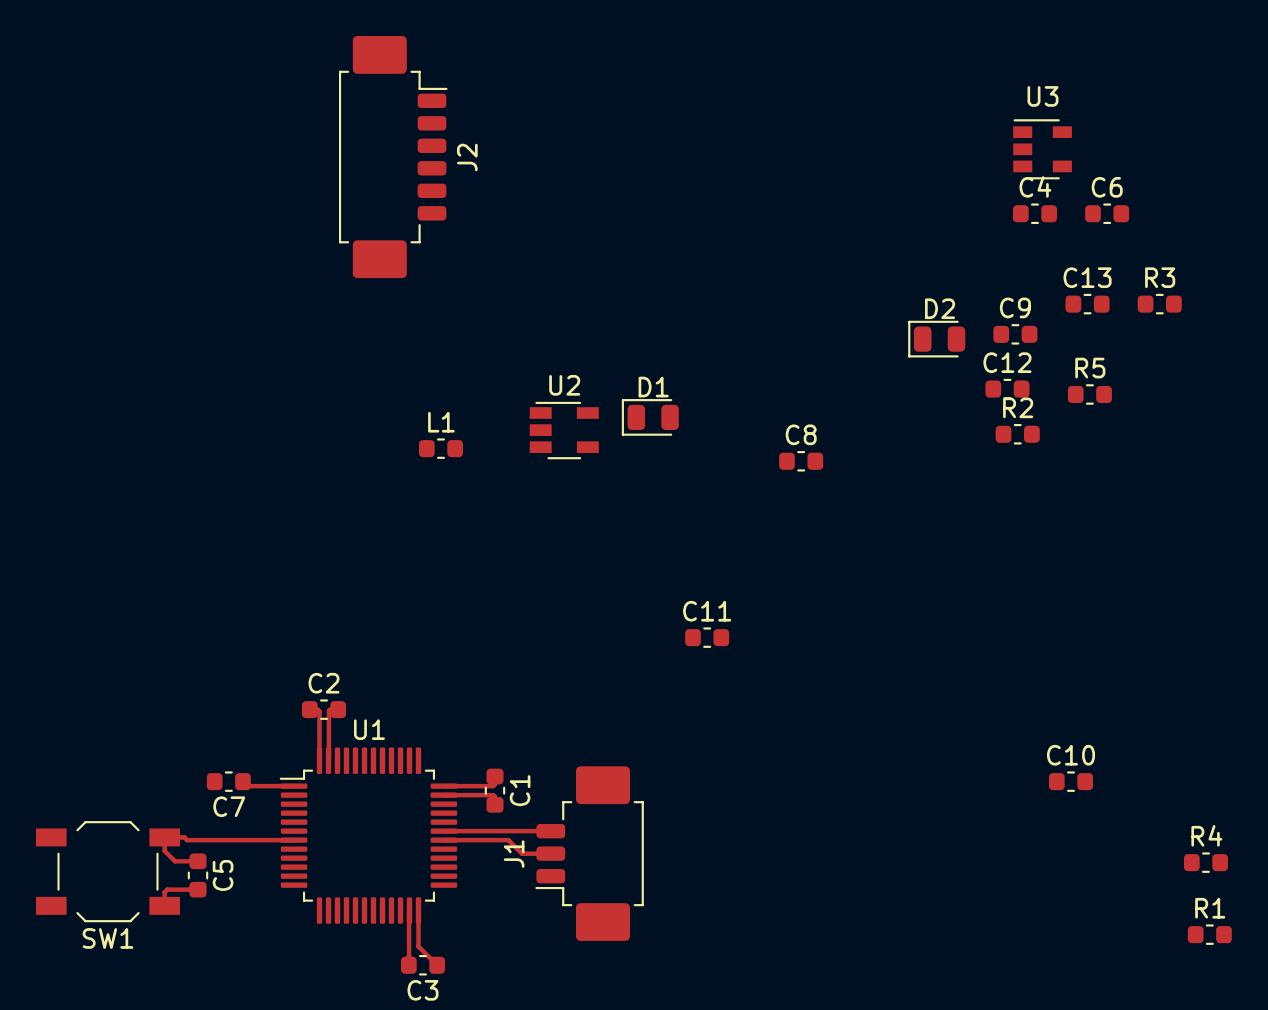
[picture p9: board hw/scu/main/main.kicad_pcb from above]

Board: 2 copper layers, 27 parts (0 on the bottom side), 16 nets.

Parts:
C1, C2, C3, C5, C7: 100n; C_0603_1608Metric
C4, C9, C11: 4.7u; C_0603_1608Metric
C6: 10n; C_0603_1608Metric
C8, C10, C12: 1u; C_0603_1608Metric
C13: 10u; C_0603_1608Metric
D1, D2: LED; LED_0805_2012Metric
J1: Conn_01x03_MountingPin; Molex_PicoBlade_53261-0371_1x03-1MP_P1.25mm_Horizontal
J2: Conn_01x06_MountingPin; Molex_PicoBlade_53261-0671_1x06-1MP_P1.25mm_Horizontal
L1: 10u; L_0603_1608Metric
R1, R2, R3, R4: 10k; R_0603_1608Metric
R5: 470k; R_0603_1608Metric
SW1: SW_Push; SW_SPST_TL3342
U1: STM32F072C8Tx; LQFP-48_7x7mm_P0.5mm
U2: LM3670MF; TSOT-23-5
U3: LP5907MFX-3.3; SOT-23-5

Connections:
/3V3_A: C6.1, C8.1, C12.1, U1.9, U3.5
/3V3_D: C1.1, C2.1, C3.1, C4.1, C7.1, C9.1, C13.1, J2.1, L1.2, R4.2, U1.1, U1.24, U1.36, U1.48, U2.4
/LED_1: D1.2, U1.27
/LED_2: D2.2, U1.28
/NRST: C5.1, J2.5, SW1.2, U1.7
/SWCLK: J2.2, U1.37
/SWDIO: J2.4, U1.34
/USART1_RX: J1.3, U1.31
/USART1_TX: J1.2, U1.30
/V_USB: C10.1, C11.1, R5.1, U2.1, U2.3, U3.1
GND: C1.2, C2.2, C3.2, C4.2, C5.2, C6.2, C7.2, C8.2, C9.2, C10.2, C11.2, C12.2, C13.2, J1.1, J1.MP, J2.3, J2.MP, R1.2, R2.1, R3.1, SW1.1, U1.8, U1.23, U1.35, U1.47, U2.2, U3.2
unnamed: D1.1, R2.2
unnamed: D2.1, R3.2
unnamed: L1.1, U2.5
unnamed: R1.1, R4.1, U1.44
unnamed: R5.2, U3.3
