VerkkuUkkeli/Kiihdytin/(commit log)

2019-12-18 Start adding STM32F072 reference design schematic.
    [main.kicad_pcb, main.sch]
2019-12-21 Add HSE crystal
    [main.kicad_pcb, main.sch]
2021-01-18 Add electromagnet driver schematics
    [relelauta.sch]
2021-01-31 Finish laying out relelauta v2.0 PCB. Minor tweaks to motherboard.
    [main-B_Cu.gbr, main-B_Mask.gbr, main-B_SilkS.gbr, main-Edge_Cuts.gbr, main-F_Cu.gbr, main-F_Mask.gbr, main-F_SilkS.gbr, main-GND.gbr]
2021-01-31 Add missing silkscreen markings
    [relelauta.kicad_pcb]
2021-01-31 Board layouts before checking gerbers for alignment
    [main.kicad_pcb, main.sch, power.sch, relelauta.kicad_pcb, sensorilauta.kicad_pcb, sensorilauta.sch]
